urish/floppy-disk-sao/(commit log)

2019-11-09 feat: add full size version
    [floppy-sao-fullsize.kicad_pcb]
2019-11-09 fix: remove extra track
    [floppy-sao.kicad_pcb]
2019-11-09 fix: U2 value in schematic
    [floppy-sao.sch]
2019-11-09 feat: add order number placeholder
    [floppy-sao-fullsize.kicad_pcb, floppy-sao.kicad_pcb]
2019-12-27 fix: activity LED logic inverted
    It should be on when SCL is low and not high
    Replaced N-Channel MOSFET with a P-Channel MOSFET.
    Also enlarged LED silk screen drawing.
    [floppy-sao-fullsize.kicad_pcb, floppy-sao.kicad_pcb, floppy-sao.sch]
2020-01-06 feat: add I²C pullups
    [floppy-sao.kicad_pcb, floppy-sao.sch]
2020-01-16 feat: add AramCon logo
    [floppy-sao.kicad_pcb]
2020-01-16 feat: add SMD-only version
    using SMD 6-pin IDC connector
    [floppy-sao-smd.kicad_pcb, floppy-sao-smd.sch]
2020-01-17 cleanup: remove unused PCB tracks
    [floppy-sao-smd.kicad_pcb]
2022-04-09 feat: replace conference logo with Wokwi logo
    [floppy-sao-fullsize.kicad_pcb, floppy-sao-smd.kicad_pcb, floppy-sao.kicad_pcb]
