urish/floppy-disk-sao/(notices)

Notices in the files:
floppy-sao-fullsize.kicad_pcb:
© 2019, Uri Shaked
floppy-sao-smd.kicad_pcb:
© 2020 Uri Shaked
